beauahill/Satellite1/acoustics/response_RS100-4.png

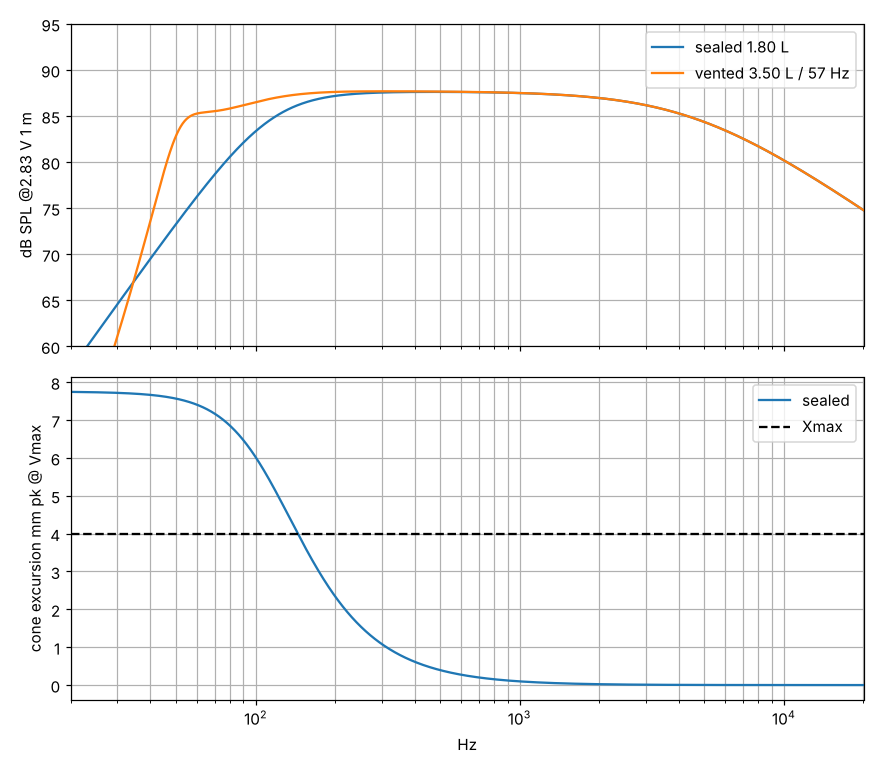
acoustics/response_RS100-4.png
