beauahill/Satellite1/cad/out/render.png

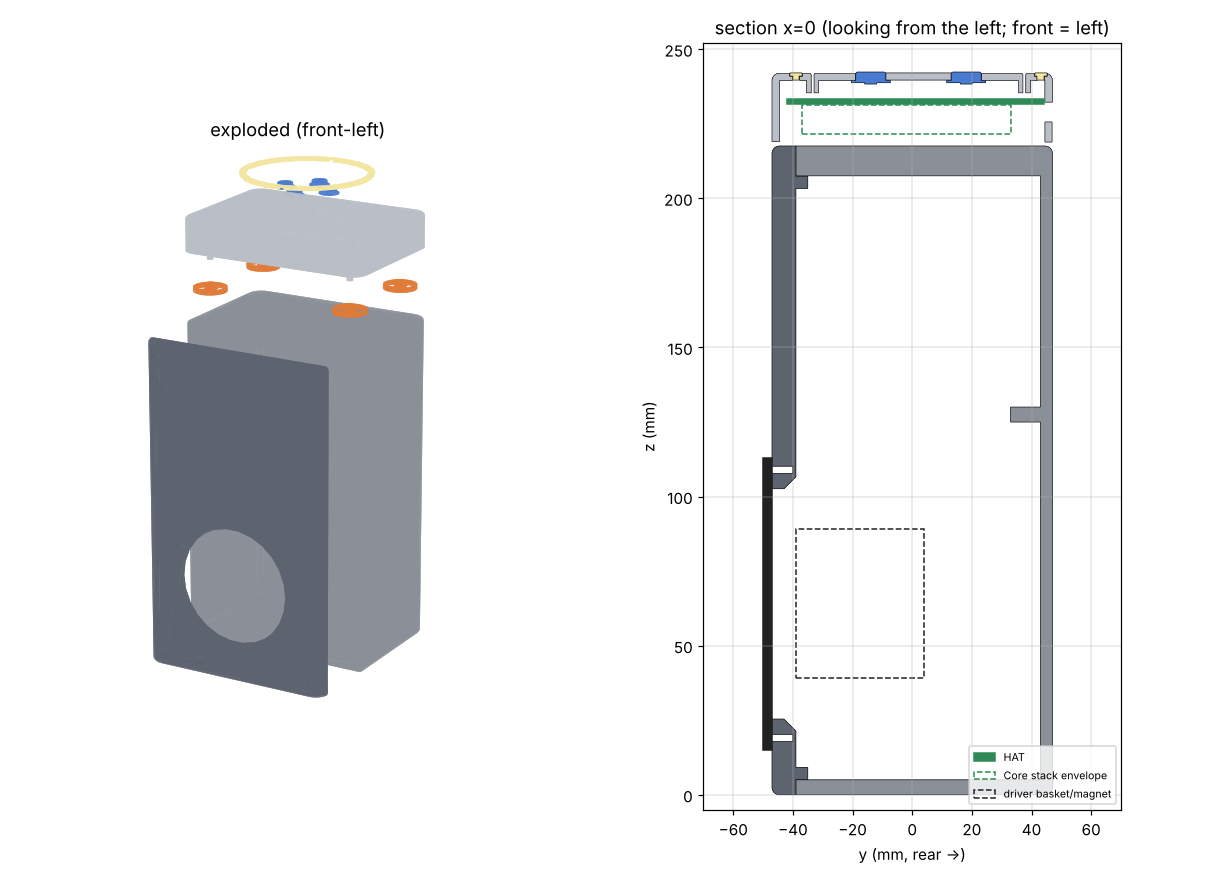
cad/out/render.png
