beauahill/Satellite1/cad/out/render_head.png

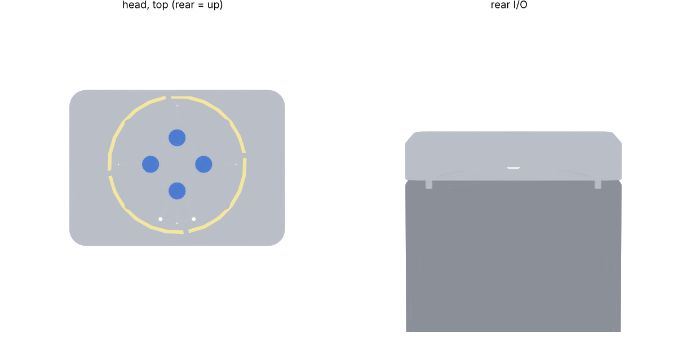
cad/out/render_head.png
