beauahill/Satellite1/cad/out/assembly.step

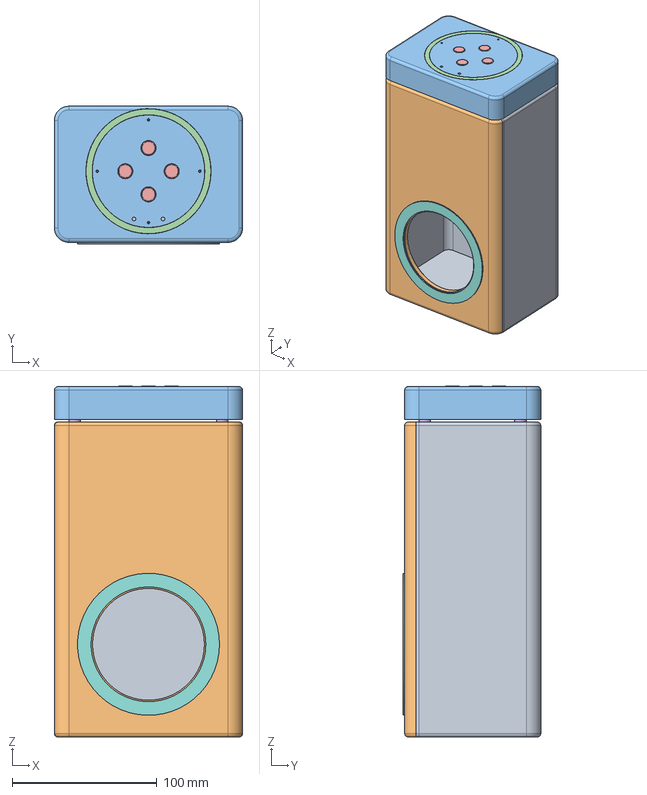
[picture p8: CAD file, 2026-11-03]
cad/out/assembly.step
130.0 x 95.0 x 242.3 mm
chamber
baffle
head
diffuser
button_cap
isolator
mic_gasket_x4
driver_gasket
button_cap_2
button_cap_3
button_cap_4
mic_gasket_2
mic_gasket_3
mic_gasket_4
isolator_2
isolator_3
isolator_4
