beauahill/Satellite1/cad/out/step/button_cap.step

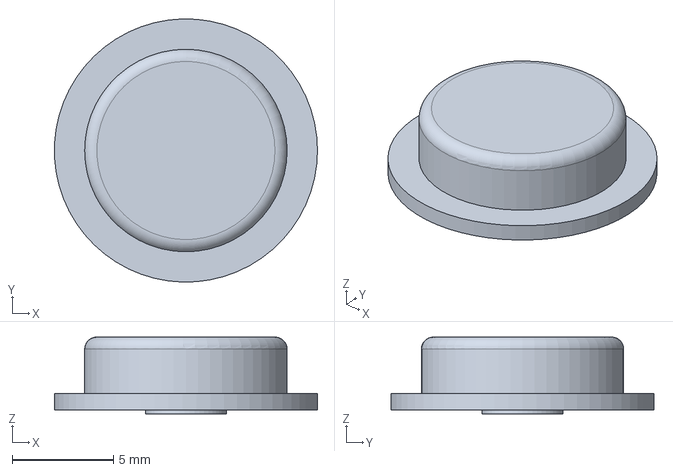
[picture p9: CAD file, 2026-11-03]
cad/out/step/button_cap.step
13.0 x 13.0 x 3.80 mm
