beauahill/Satellite1/cad/out/step/head.step

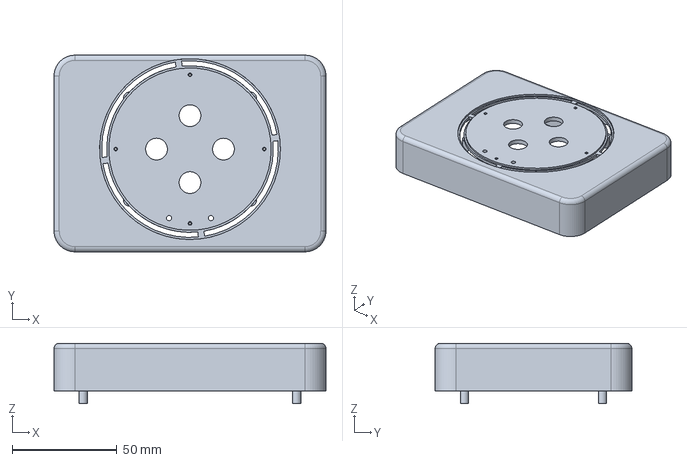
[picture p10: CAD file, 2026-11-03]
cad/out/step/head.step
130.0 x 94.0 x 28.9 mm
