beauahill/Satellite1/cad/out/step/chamber.step

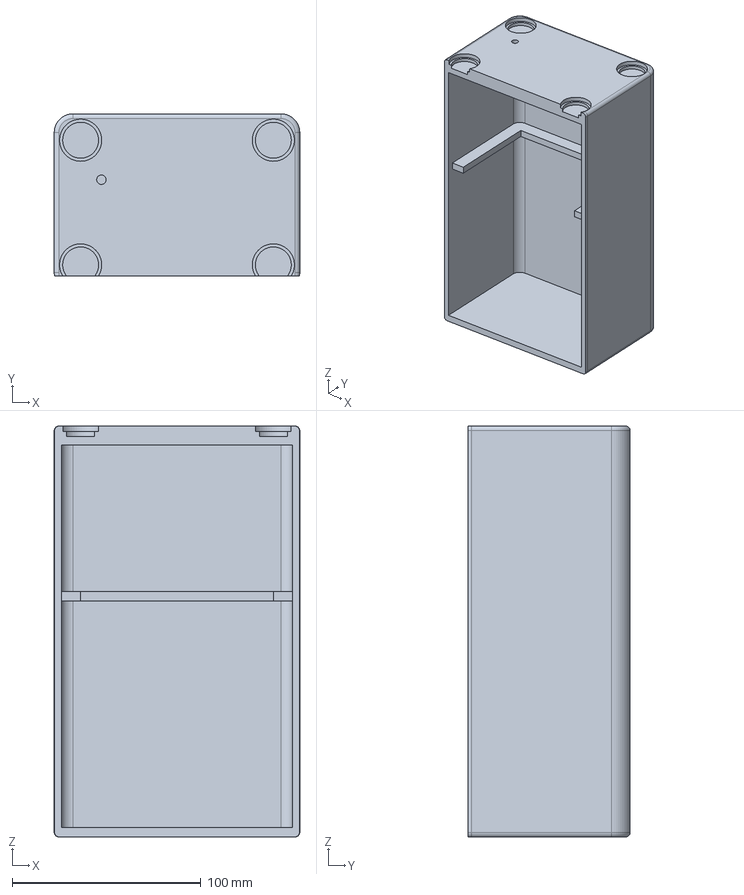
[picture p11: CAD file, 2026-11-03]
cad/out/step/chamber.step
130.0 x 86.0 x 217.5 mm
