beauahill/Satellite1/cad/out/step/isolator.step

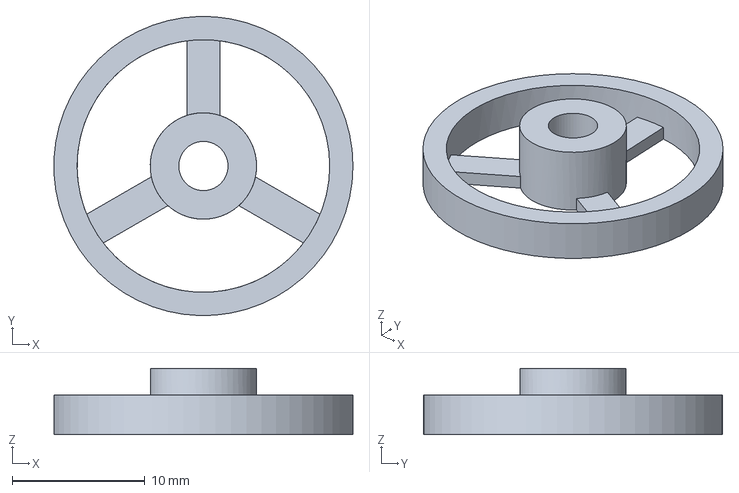
[picture p12: CAD file, 2026-11-03]
cad/out/step/isolator.step
22.5 x 22.5 x 5.00 mm
