beauahill/Satellite1/cad/out/step/driver_gasket.step

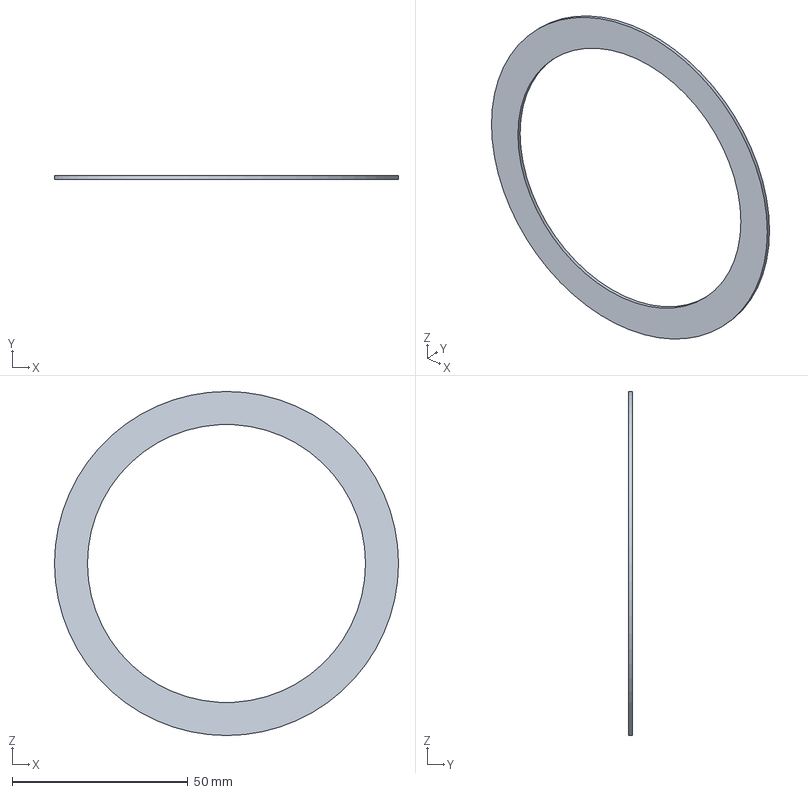
[picture p13: CAD file, 2026-11-03]
cad/out/step/driver_gasket.step
98.0 x 1.00 x 98.0 mm
