beauahill/Satellite1/cad/out/step/mic_gasket_x4.step

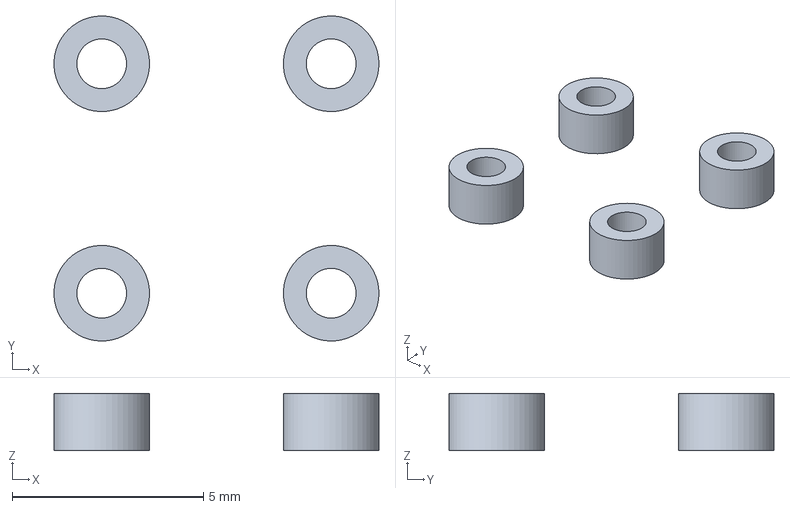
[picture p14: CAD file, 2026-11-03]
cad/out/step/mic_gasket_x4.step
8.50 x 8.50 x 1.50 mm
