beauahill/Satellite1/cad/out/step/diffuser.step

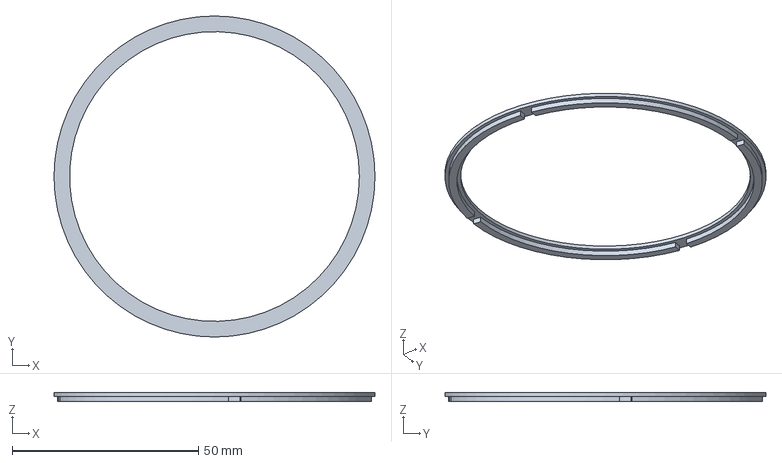
[picture p15: CAD file, 2026-11-03]
cad/out/step/diffuser.step
86.2 x 86.2 x 2.40 mm
