beauahill/Satellite1/cad/out/step/baffle.step

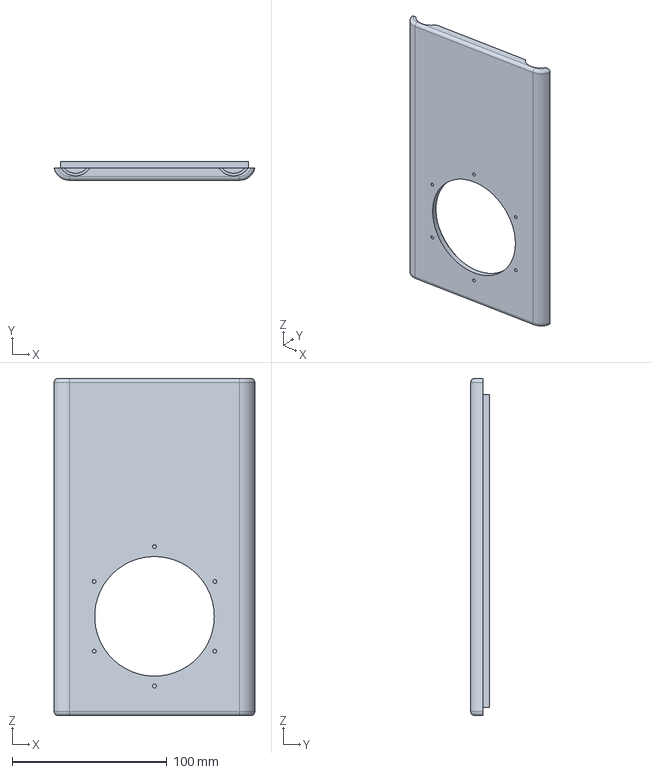
[picture p16: CAD file, 2026-11-03]
cad/out/step/baffle.step
129.6 x 12.0 x 217.5 mm
