beauahill/Satellite1/(list of files, cad)

Other CAD files:
cad/out/baffle.stl
cad/out/button_cap.stl
cad/out/chamber.stl
cad/out/diffuser.stl
cad/out/driver_gasket.stl
cad/out/head.stl
cad/out/isolator.stl
cad/out/mic_gasket_x4.stl
