beauahill/Satellite1/(commit log)

2026-10-30 Add Satellite1 sealed full-range speaker enclosure design
    - acoustics/box_design.py: Thiele/Small simulator (sealed/vented, F3,
    excursion, port speed, TAS2780 limits, isolator resonance)
    - cad/enclosure.py: parametric CadQuery enclosure with HAT fit check
    - cad/out: print-oriented STLs and assembly STEP
    - tools/board_extract: scripts that extract board data from FPH STEP files
    - README: board facts, driver shortlist, alignment, print/assembly notes
    Claude-Session: https://claude.ai/code/session_014zeCf4QyT7zaMVzYCFL33d
    [assembly.step, baffle.stl, button_cap.stl, chamber.stl, diffuser.stl, driver_gasket.stl, head.stl, isolator.stl]
2026-10-30 Add per-part STEP export, damping plan, print settings, BOM and assembly notes
    - enclosure.py: export one STEP per part in assembled position; subtract
    wall-damping displacement when solving cavity height; deepen driver pilots
    - README: print settings for a stiff/damped cabinet, damping placement,
    BOM with part numbers and links, step-by-step assembly with leak test
    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
    [assembly.step, baffle.step, baffle.stl, button_cap.step, button_cap.stl, chamber.step, chamber.stl, diffuser.step]
2026-10-30 Add 3D renders and exploded assembly diagram
    - render_scene.py exports enclosure, representative RS100-4, FPH HAT/Core
    boards and damping parts with explode offsets
    - render/render.html + render.mjs render hero, cutaway, top and a labelled
    exploded assembly diagram with three.js in headless Chromium
    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
2026-11-03 README: Arachne walls, 9 chamber walls, no ironing
    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
2026-11-03 Export mic gasket at its 1.5 mm free thickness, not compressed height
    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
    [assembly.step, baffle.step, button_cap.step, chamber.step, diffuser.step, driver_gasket.step, head.step, isolator.step]
2026-11-03 Fix front isolator sockets cut off at the baffle joint
    The front sockets (y = -33, r = 11.15) extend 5 mm past the chamber/baffle
    split, but were only cut into the chamber. Cut them into the baffle too and
    add a self-check that probes every socket in the glued chamber + baffle.
    Chamber geometry is unchanged.
    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
    [assembly.step, baffle.step, baffle.stl, button_cap.step, chamber.step, diffuser.step, driver_gasket.step, head.step]
2026-11-03 Press-fit isolator rings; document how the head is retained
    Isolator ring OD 22.5 in the existing 22.3 socket (chamber unchanged), so the
    isolators stay put when the head is lifted. README explains head retention and
    the verified head/body alignment.
    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
    [assembly.step, baffle.step, button_cap.step, chamber.step, diffuser.step, driver_gasket.step, head.step, isolator.step]
2026-11-03 Ship mic gaskets as a 4-up object to dodge Bambu Studio auto inch scaling
    Bambu Studio (libslic3r Model::looks_like_imperial_units) silently scales any
    imported object under 8 mm3 by 25.4. One gasket is 6.9 mm3, so it imported at
    71 x 71 x 38 mm. Export the four as one 27.7 mm3 object and fail the export if
    any printed part drops below 8 mm3.
    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
    [assembly.step, baffle.step, button_cap.step, chamber.step, diffuser.step, driver_gasket.step, head.step, isolator.step]
2026-11-03 Full board fit check; front HAT screws through the Core; wider margins
    - fit_check.py: places FPH HAT (seated on bosses) and Core (on its mounting
    holes, 10 mm stack) with all 4 screws; checks 253 board components against
    every printed part plus named clearances. All pass.
    - The Core's holes sit under the HAT's front holes, so those screws must be
    M3x16 through both boards; HAT pilots deepened to 7 mm.
    - Button pre-travel 0.11 -> 0.31 mm (rev6.1 PCB is 1.51 mm).
    - Mic gasket OD 2.8 -> 2.5 mm so it can't hang off the 3 mm mic body.
    - Generic check: chamber + baffle must equal the unsplit body with all
    features. Chamber, baffle and isolator geometry unchanged.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
    [assembly.step, baffle.step, button_cap.step, button_cap.stl, chamber.step, diffuser.step, driver_gasket.step, head.step]
